xDocka15/Bachelor_project/3D/Coil/FreeCad/Kostra.FCStd

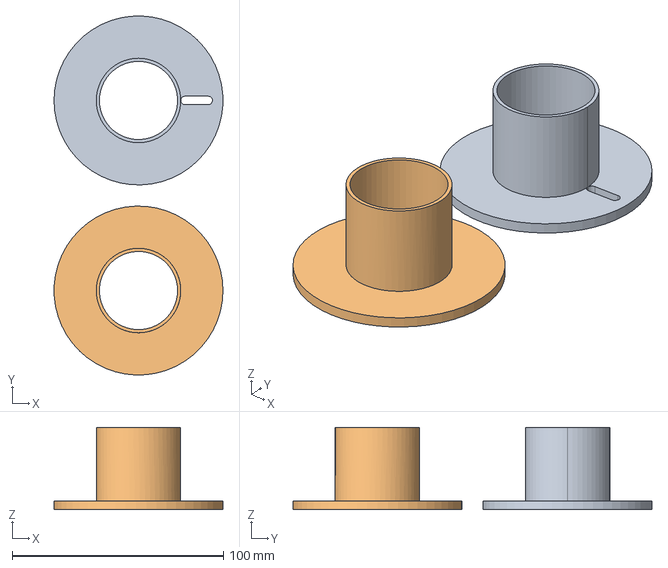
[picture p1: CAD file, 2024-08-05]
3D/Coil/FreeCad/Kostra.FCStd
80.0 x 170.0 x 39.0 mm
Kostra2
Kostra1
