xDocka15/Bachelor_project/3D/Coil/stl/kostra1.stl

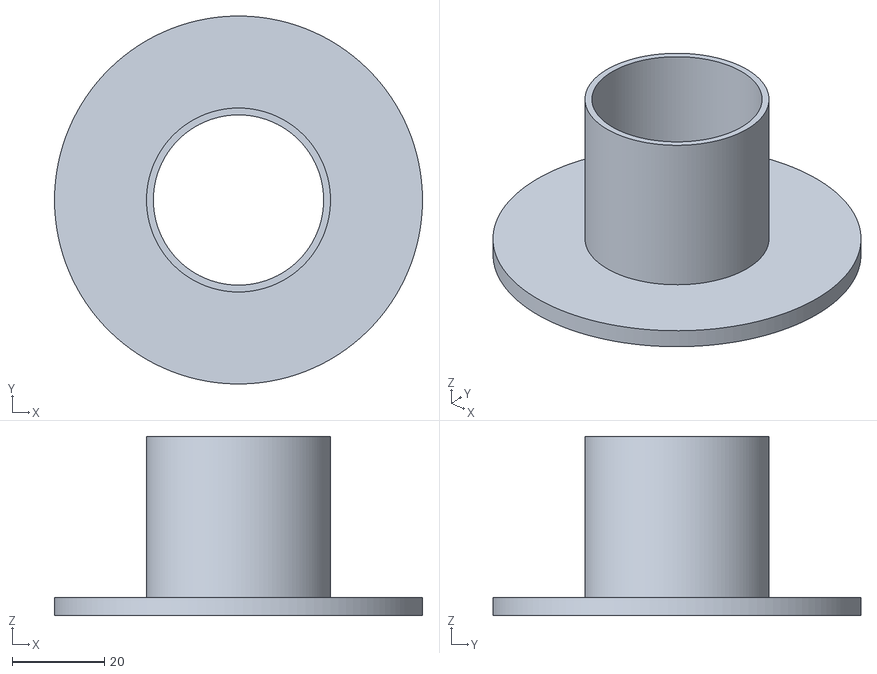
[picture p2: CAD file, 2024-08-05]
3D/Coil/stl/kostra1.stl
80.0 x 80.0 x 39.0
