xDocka15/Bachelor_project/3D/MainModule/FreeCad/HlavniModul.FCStd

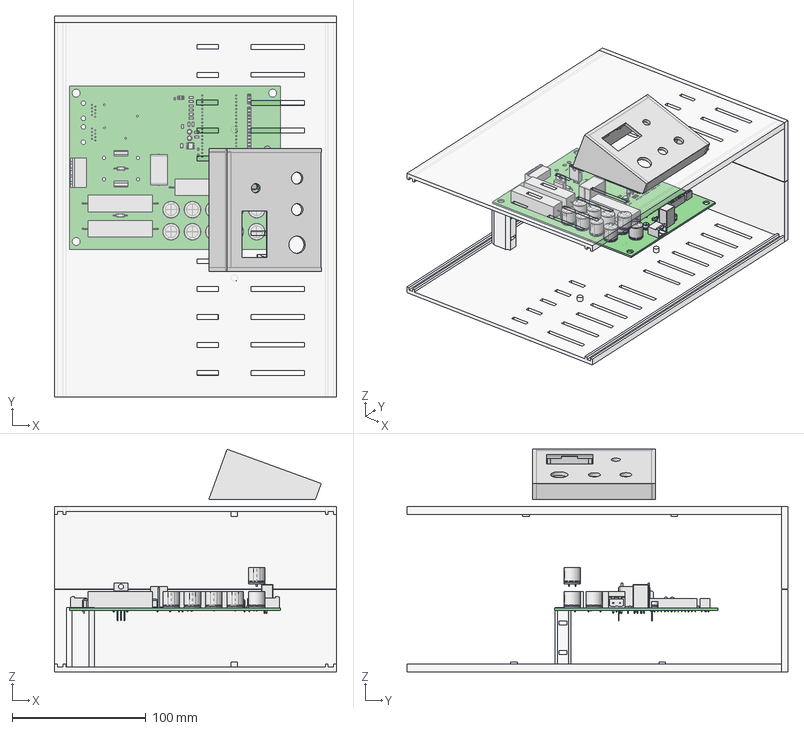
[picture p3: CAD file, 2024-08-05]
3D/MainModule/FreeCad/HlavniModul.FCStd
211.0 x 285.0 x 166.5 mm
power_module PCB
plate001
side
side
plate002
sloupek
panel
