xDocka15/Bachelor_project/3D/MainModule/stl/sloupek.stl

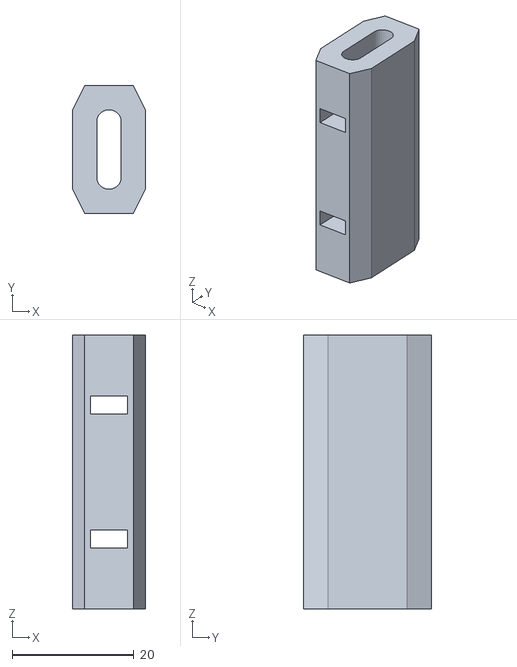
[picture p4: CAD file, 2024-08-05]
3D/MainModule/stl/sloupek.stl
12.0 x 21.0 x 45.0
