xDocka15/Bachelor_project/3D/Sensor/FreeCad/Senzor.FCStd

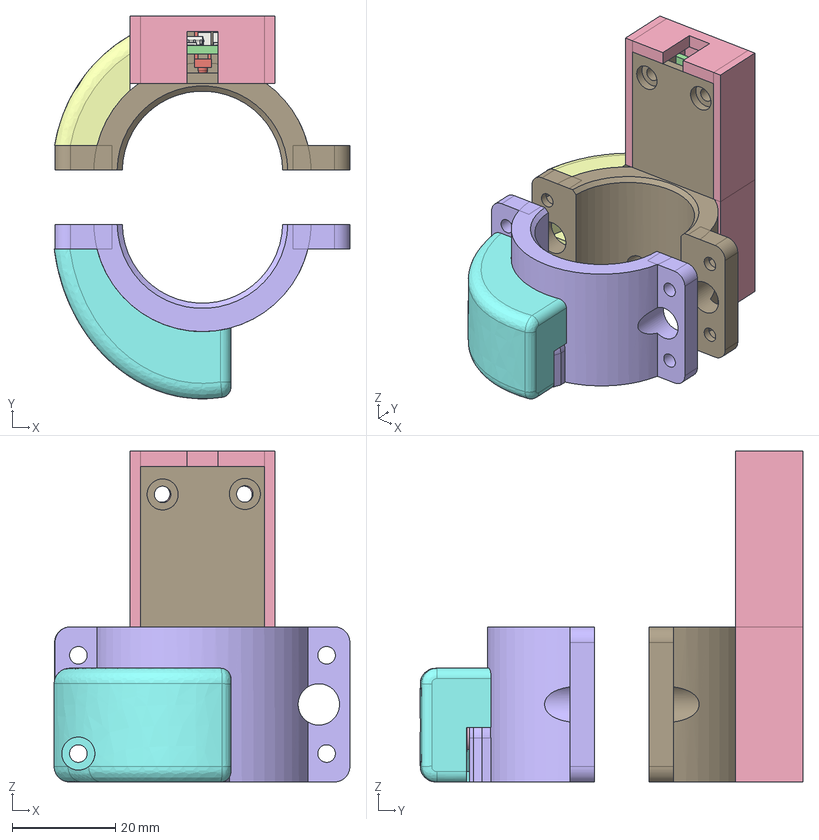
[picture p5: CAD file, 2024-08-05]
3D/Sensor/FreeCad/Senzor.FCStd
57.2 x 74.0 x 64.0 mm
LED_D5.0mm_Clear
Senzor_Top
Senzor_Bot
Sensor PCB001
Senzor_kryt_DPS
Senzor_kryt_Top
Senzor_kryt_Bot
