xDocka15/Bachelor_project/3D/Sensor/stl/Senzor_Top.stl

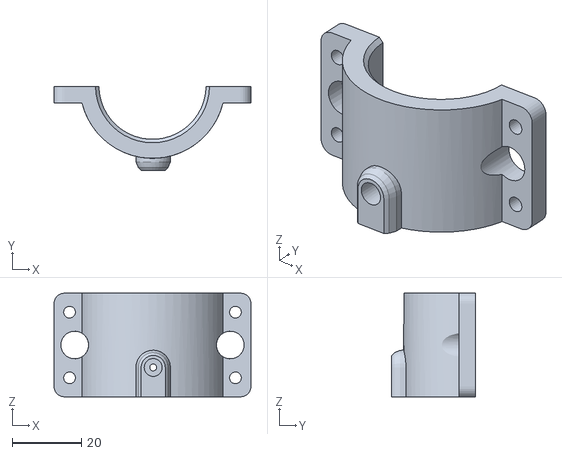
[picture p6: CAD file, 2024-08-05]
3D/Sensor/stl/Senzor_Top.stl
57.0 x 24.2 x 30.0
