xDocka15/Bachelor_project/3D/MainModule/stl/panel.stl

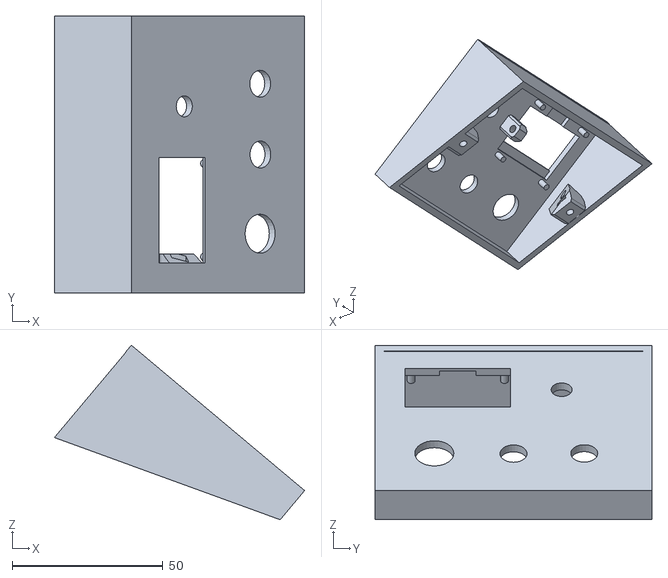
[picture p7: CAD file, 2024-08-05]
3D/MainModule/stl/panel.stl
83.1 x 92.0 x 57.9
