xDocka15/Bachelor_project/3D/Sensor/stl/Senzor_kryt_drátu_Bot.stl

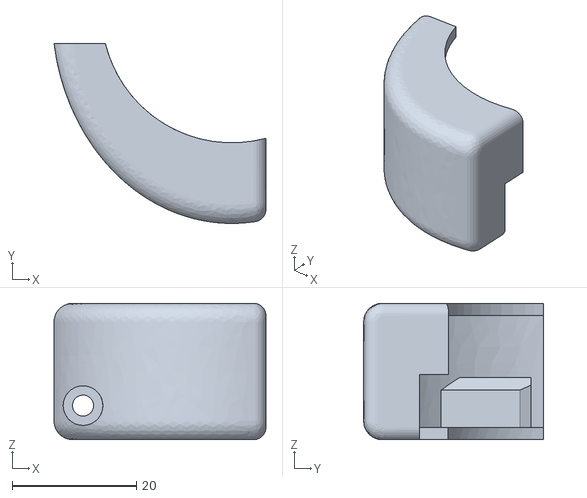
[picture p8: CAD file, 2024-08-05]
3D/Sensor/stl/Senzor_kryt_drátu_Bot.stl
34.2 x 29.0 x 22.0
