xDocka15/Bachelor_project/3D/Sensor/stl/Senzor_kryt_DPS.stl

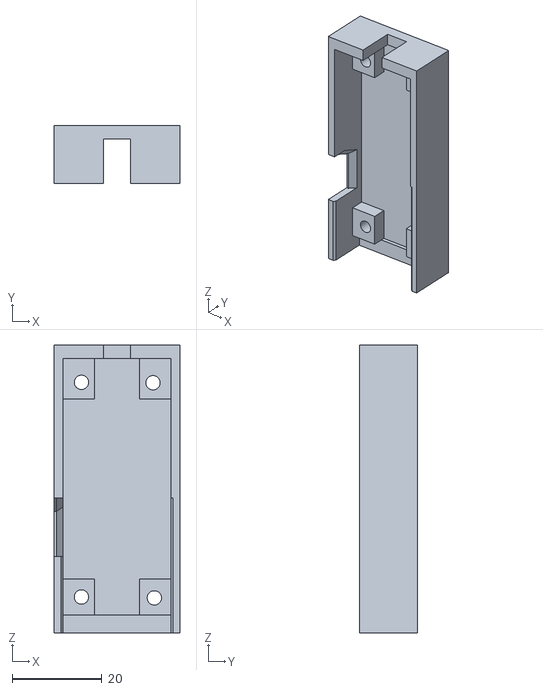
[picture p9: CAD file, 2024-08-05]
3D/Sensor/stl/Senzor_kryt_DPS.stl
28.0 x 13.0 x 64.0
