xDocka15/Bachelor_project/3D/Sensor/stl/Senzor_kryt_drátu_Top.stl

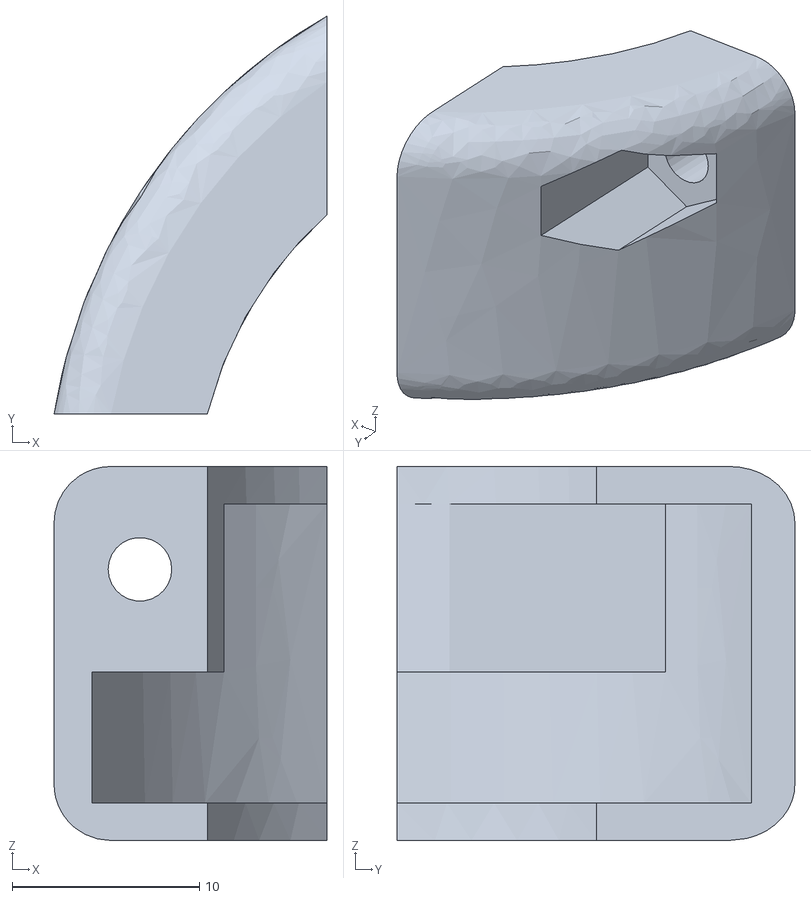
[picture p10: CAD file, 2024-08-05]
3D/Sensor/stl/Senzor_kryt_drátu_Top.stl
14.6 x 21.3 x 20.0
