xDocka15/Bachelor_project/3D/Sensor/stl/Senzor_Bot.stl

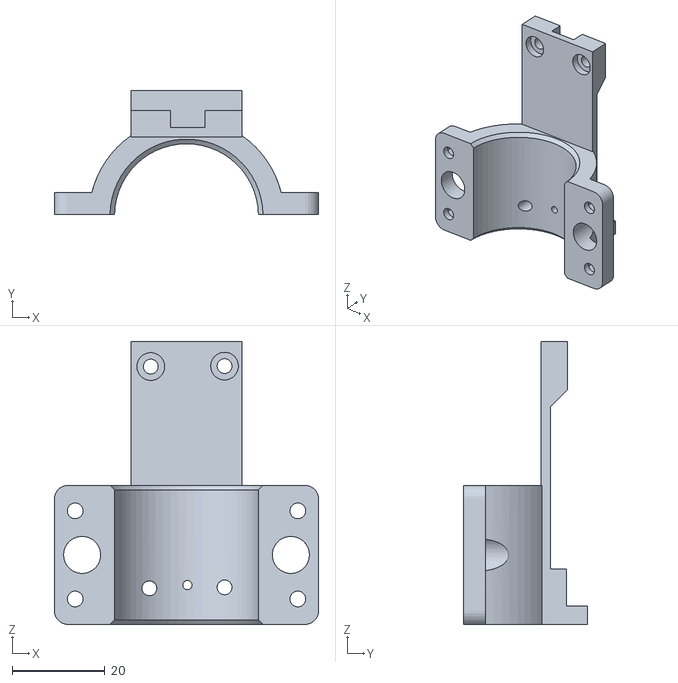
[picture p11: CAD file, 2024-08-05]
3D/Sensor/stl/Senzor_Bot.stl
57.0 x 26.8 x 61.0
