xDocka15/Bachelor_project/(list of files, cad)

Other CAD files:
3D/Coil/stl/kostra2.stl
