xDocka15/Bachelor_project/DPS/Sensor/KiCad/Sensor.kicad_pcb

## KiCad design DPS/Sensor/KiCad/Sensor.kicad_pcb (2024-08-05)

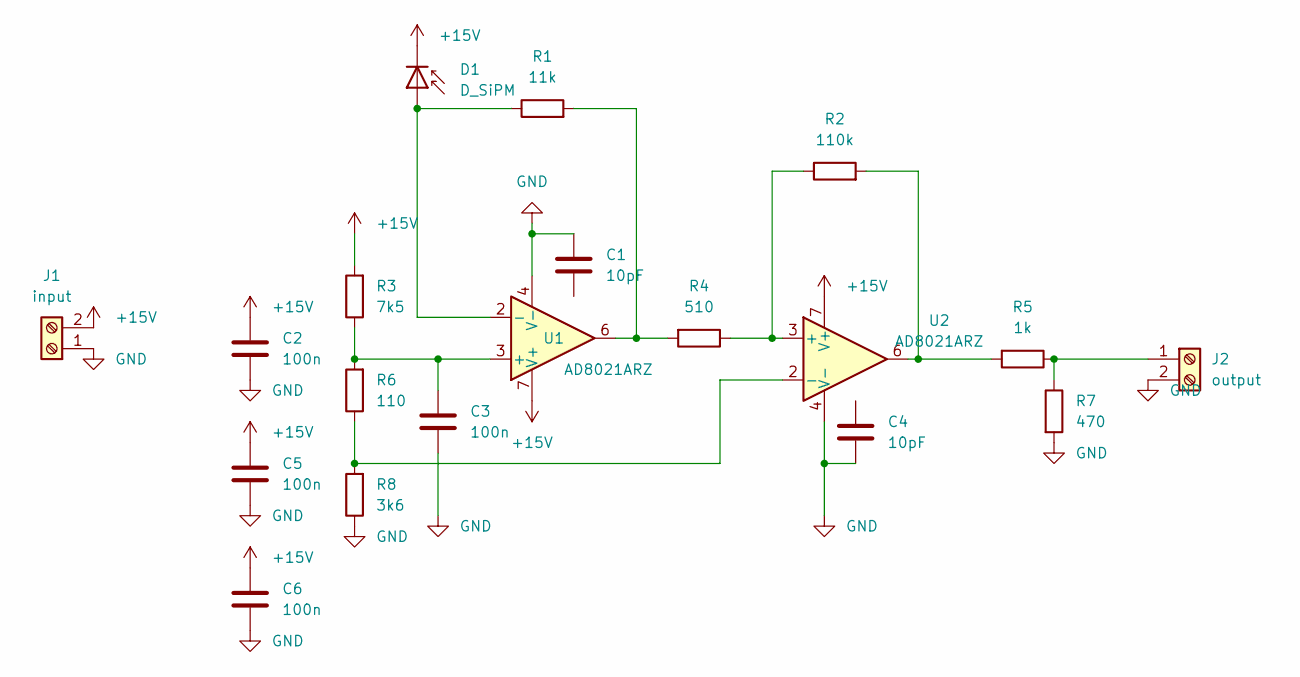
[picture p12: schematic Sensor.kicad_sch]

Parts:
C1, C4: 10pF; C_0805_2012Metric_Pad1.18x1.45mm_HandSolder
C2, C3, C5, C6: 100n; C_1210_3225Metric_Pad1.33x2.70mm_HandSolder
D1: D_SiPM; LED_D1.8mm_W3.3mm_H2.4mm
J1: input; PinHeader_1x02_P2.54mm_Vertical
J2: output; PinHeader_1x02_P2.54mm_Vertical
R1: 11k; R_1206_3216Metric_Pad1.30x1.75mm_HandSolder
R2: 110k; R_1206_3216Metric_Pad1.30x1.75mm_HandSolder
R3: 7k5; R_1206_3216Metric_Pad1.30x1.75mm_HandSolder
R4: 510; R_1206_3216Metric_Pad1.30x1.75mm_HandSolder
R5: 1k; R_1206_3216Metric_Pad1.30x1.75mm_HandSolder
R6: 110; R_1206_3216Metric_Pad1.30x1.75mm_HandSolder
R7: 470; R_1206_3216Metric_Pad1.30x1.75mm_HandSolder
R8: 3k6; R_1206_3216Metric_Pad1.30x1.75mm_HandSolder
U1, U2: AD8021ARZ; SOIC-8_3.9x4.9mm_P1.27mm

Connections:
+15V: C2.1, C5.1, C6.1, D1.1 (K), J1.2, R3.2, U1.7 (V+), U2.7 (V+)
GND: C1.1, C2.2, C3.2, C4.2, C5.2, C6.2, J1.1, J2.2, R7.2, R8.1, U1.4 (V-), U2.4 (V-)
unnamed: C3.1, R3.1, R6.2, U1.3 (+)
unnamed: D1.2 (A), R1.1, U1.2 (-)
unnamed: J2.1, R5.1, R7.1
unnamed: R1.2, R4.2, U1.6
unnamed: R2.1, R4.1, U2.3 (+)
unnamed: R2.2, R5.2, U2.6
unnamed: R6.1, R8.2, U2.2 (-)

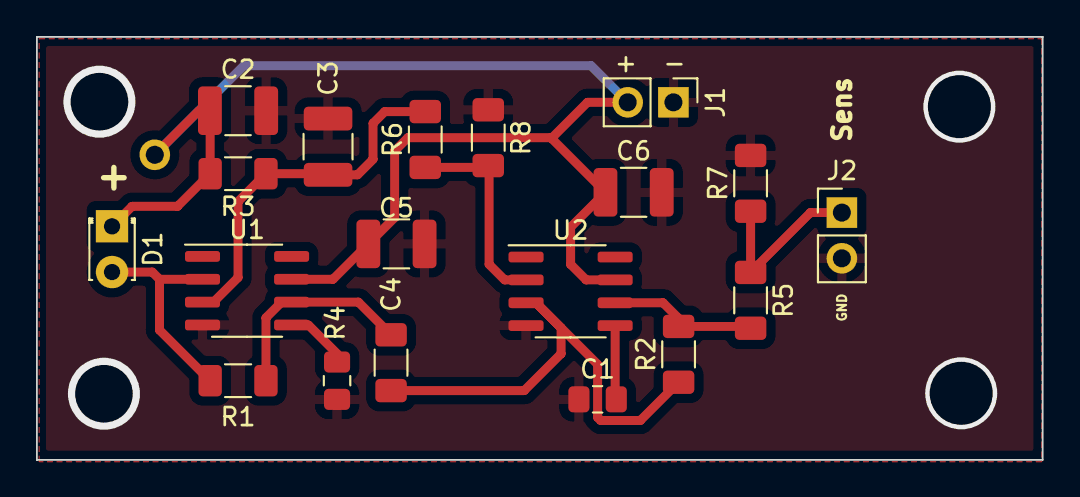
[picture p13: board Sensor.kicad_pcb from above]

Board: 2 copper layers, 55.9 x 23.5 mm, 19 parts (0 on the bottom side), 9 nets.
