xDocka15/Bachelor_project/DPS/Main_module/KiCad/power_module.kicad_pcb

## KiCad design DPS/Main_module/KiCad/power_module.kicad_pcb (2024-08-05)

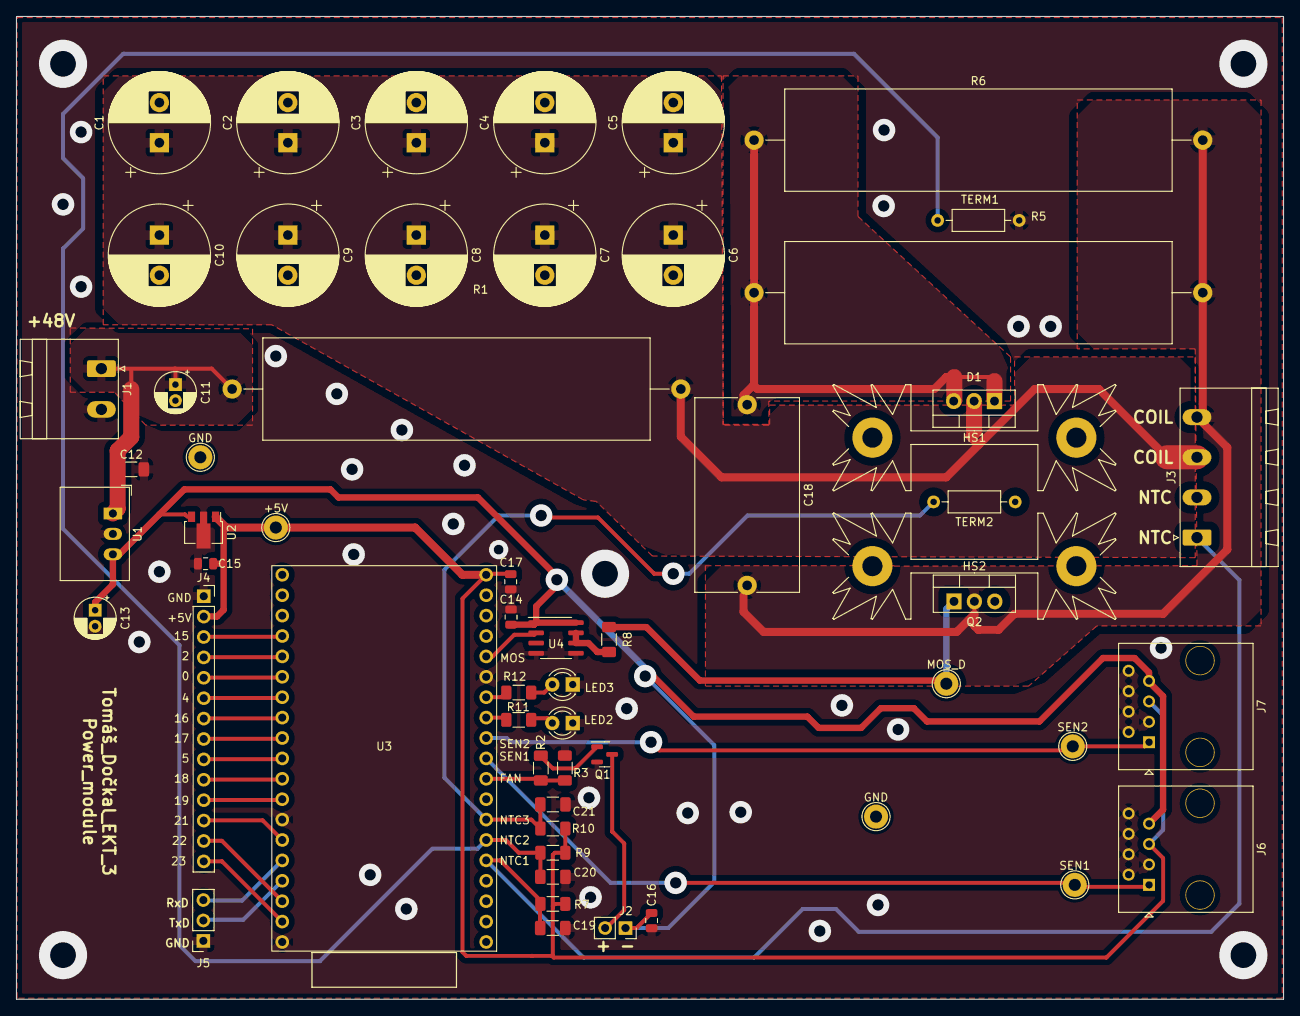
[picture p14: board power_module.kicad_pcb from above]

Board: 2 copper layers, 157.8 x 122.4 mm, 58 parts (0 on the bottom side), 36 nets.

Parts:
+5V: TestPoint_THTPad_D3.0mm_Drill1.5mm
C1, C2, C3, C4, C5, C6, C7, C8, C9, C10: 560uF; CP_Radial_D12.5mm_P5.00mm
C11, C13: 10uF; CP_Radial_D5.0mm_P2.00mm
C12, C19, C20, C21: 100nF; C_1206_3216Metric_Pad1.33x1.80mm_HandSolder
C14, C15, C16, C17: 100nF; C_0805_2012Metric
C18: 2uF; C_Rect_L24.0mm_W12.8mm_P22.50mm_MKT
D1: MBR30150CT; TO-220-3_Vertical
GND: TestPoint_THTPad_D3.0mm_Drill1.5mm
GND#2: TestPoint_THTPad_D3.0mm_Drill1.5mm
HS1: Heatsink_D1; Heatsink_Fischer_SK104-STC-STIC_35x13mm_2xDrill2.5mm
HS2: Heatsink_MOS; Heatsink_Fischer_SK104-STC-STIC_35x13mm_2xDrill2.5mm
J1: +48V; PhoenixContact_MSTBA_2,5_2-G-5,08_1x02_P5.08mm_Horizontal
J2: FAN; PinSocket_1x02_P2.54mm_Vertical
J3: COIL+NTC; PhoenixContact_MSTBA_2,5_4-G_1x04_P5.00mm_Horizontal
J4: Display; PinSocket_1x14_P2.54mm_Vertical
J5: UART; PinSocket_1x03_P2.54mm_Vertical
J6, J7: RJ45; RJ45_OST_PJ012-8P8CX_Vertical
LED2, LED3: LED; LED_D3.0mm
MOS_D: TestPoint_THTPad_D3.0mm_Drill1.5mm
Q1: Q_NMOS_GDS; SOT-23
Q2: IXFP60N25X3; TO-220-3_Vertical
R1: 4R7; R_Axial_Power_L48.0mm_W12.5mm_P55.88mm
R2, R8: 10; R_1206_3216Metric_Pad1.30x1.75mm_HandSolder
R3: 100k; R_1206_3216Metric_Pad1.30x1.75mm_HandSolder
R5, R6: 10; R_Axial_Power_L48.0mm_W12.5mm_P55.88mm
R7, R9, R10: 4k7; R_1206_3216Metric_Pad1.30x1.75mm_HandSolder
R11, R12: 67R; R_1206_3216Metric_Pad1.30x1.75mm_HandSolder
SEN1, SEN2: TestPoint_THTPad_D3.0mm_Drill1.5mm
TERM1, TERM2: 100k; R_Axial_DIN0207_L6.3mm_D2.5mm_P10.16mm_Horizontal
U1: AMSRU-7815JZ; Converter_DCDC_RECOM_R-78HB-0.5_THT
U2: MC78L05ACHT1G; SOT-89-3
U3: esp32; ESP32
U4: MCP14A0302-E/SN; SOIC-8_3.9x4.9mm_P1.27mm

Connections:
+5V: +5V.1, C15.1, C17.1, J4.2, J6.5, J7.5, R7.2, R9.2, R10.2, U2.1 (OUT), U3.19 (5V)
+15V: C13.1, C14.1, C16.1, J2.1, J6.7, J7.7, U1.3 (OUT), U2.3 (IN), U4.1 (VDD), U4.8 (VDD)
+48V: C11.1, C12.1, J1.1, R1.1, U1.1 (IN)
COIL1: C1.1, C2.1, C3.1, C4.1, C5.1, C6.1, C7.1, C8.1, C9.1, C10.1, D1.2 (K), J3.3, R1.2
COIL2: C18.2, J3.4, Q2.2 (D), R5.2, R6.2
FAN-: J2.2, Q1.3 (D)
FAN_PWM: R2.1, R3.1, U3.9 (1025)
LED_1: R11.1, U3.12 (1014)
LED_2: R12.1, U3.13 (1012)
MOS: U3.15 (1013), U4.2 (IN)
NTC1: C19.1, J3.1, R7.1, U3.5 (1034)
NTC1_2: C1.2, C2.2, C3.2, C4.2, C5.2, C6.2, C7.2, C8.2, C9.2, C10.2, C11.2, C12.2, C13.2, C14.2, C15.2, C16.2, C17.2, C19.2, C20.2, C21.2, J1.2, J3.2, J4.1, J5.1, J6.2, J6.3, J6.4, J6.6, J6.8, J7.2, J7.3, J7.4, J7.6, J7.8, LED2.1 (K), LED3.1 (K), Q1.2 (S), Q2.3 (S), R3.2, TERM1.2, TERM2.2, U1.2 (GND), U2.2 (GND), U3.14 (GND), U3.20 (GND), U3.26 (GND), U4.4 (GND), U4.5 (GND)
NTC2: C20.1, R9.1, TERM1.1, U3.6 (1035)
NTC3: C21.1, R10.1, TERM2.1, U3.7 (1032)
unnamed: C18.1, D1.1 (A1), D1.3 (A2), R5.1, R6.1
unnamed: J4.3, U3.35 (1015)
unnamed: J4.4, U3.34 (102)
unnamed: J4.5, U3.33 (100)
unnamed: J4.6, U3.32 (104)
unnamed: J4.7, U3.31 (1016)
unnamed: J4.8, U3.30 (1017)
unnamed: J4.9, U3.29 (105)
unnamed: J4.10, U3.28 (1018)
unnamed: J4.11, U3.27 (1019)
unnamed: J4.12, U3.25 (1021)
unnamed: J4.13, U3.22 (1022)
unnamed: J4.14, U3.21 (1023)
unnamed: J5.2, U3.23 (TXD)
unnamed: J5.3, U3.24 (RXD)
unnamed: LED2.2 (A), R11.2
unnamed: LED3.2 (A), R12.2
unnamed: Q1.1 (G), R2.2
unnamed: MOS_D.1, Q2.1 (G), R8.2
unnamed: R8.1, U4.6 (OUT), U4.7 (OUT)
Sensor_1: J6.1, SEN1.1, U3.10 (1026)
Sensor_2: J7.1, SEN2.1, U3.11 (1027)
