xDocka15/Bachelor_project/(commit log)

2022-10-27 sem file upload
    [coil_spool.FCStd, vypočty2.xlsx]
2024-08-05 updated esp
    [coil_spool.FCStd, partitions.csv, vypočty2.xlsx]
2024-08-05 added 3D, DPS, Matlab
    [HlavniModul.FCStd, Kostra.FCStd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]
